hydronautics-team/DCDC_SAUVC26_PCB/Project Outputs for DCDC_SAUVC26_PCB/DCDC_SAUVC26_PCB.xlsx

Line # | Part Number | Description | Designator | Quantity
1 | Capacitor_0,01n_10_50V_X7R_0603C | Конденсатор | C1 | 1
2 | Capacitor_0,15n_10_50V_X7R_0603C | Конденсатор | C2 | 1
3 | Capacitor_0,75n_10_50V_X7R_0603C | Конденсатор | C3 | 1
4 | Capacitor_10n_10_50V_X7R_0603C | Конденсатор | C4, C26, C37 | 3
5 | Capacitor_0,1u_10_50V_X7R_0603C | Конденсатор | C5 | 1
6 | Capacitor_22u_10_25V_X7R_1210C | Конденсатор | C6, C7, C9, C11, C13, C15, C16, C18, C19, C21-23, C27, C28, C38, C39 | 16
7 | Capacitor_2,2u_10_50V_X7R_1206C | Конденсатор | C8, C10, C12, C14 | 4
8 | Capacitor_1u_10_50V_X7R_0603C | Конденсатор | C17, C20 | 2
9 | Capacitor_4,7u_10_50V_X7R_1206C | Конденсатор | C24, C25, C35, C36 | 4
10 | JCK1V101 | Конденсатор алюминиевый электролитический 100мкФ 35В 20% SMD 6,6x6,6 мм | C29, C34 | 2
11 | JCK1V331 | Конденсатор алюминиевый электролитический 1000мкФ 25В 20% Low ESR 1100мА SMD12.5x13.5мм | C30, C32, C33 | 3
12 | Capacitor_1n_10_50V_X7R_0603C | Конденсатор | C31 | 1
13 | LM5116MH | dc-dc понижающий adj 6-100v | DA1 | 1
14 | RT8279GSP | Преобразователь постоянного тока понижающий подстраиваемый выход 5А | DA2, DA4 | 2
16 | MC3306A | DC-DC понижающий/повышающий преобразователь, вход: 3 - 40 В, выход: 1,25 - 40 В 1,5 А | DD1 | 1
17 | LED | Светодиод | HL1-6 | 6
18 | CDSPRH127-150M | Индуктивность на 15 мкГн, номинальный ток 8,4 А | L1 | 1
19 | IHLP4040DZER330M11 | ЧИП-индуктивность экранированная 33мкГн ±20% 4,4A 94,5мОм 4040 | L2, L5 | 2
20 | CDSPRH127-331M | Индуктивность на 330 мкГн, номинальный ток 1,79 A | L3 | 1
21 | CDSP43-1R0M | Индуктивность на 1 мкГн, номинальный ток 4,3 A | L4 | 1
22 | res_0603_N/A | посадочное место 0603 под перемычку | R1 | 1
23 | Resistor_33k_1_0603 | Резистор номиналом 33 кОм и точностью 1% | R2, R17 | 2
 | Resistor_5.6k_1_0603 | Резистор номиналом 5,6 кОм 1% | R3 | 1
25 | Resistor_12.4k_1_0603 | Резистор номиналом 12,4 кОм и точностью 1% | R4 | 1
26 | Resistor_180k_1_0603 | Резистор номиналом 180 кОм и точностью 1% | R5 | 1
27 | Resistor_10k_1_0603 | Резистор номиналом 10 кОм и точностью 1% | R6, R14, R16 | 3
28 | Resistor_470k_1_0603 | Резистор номиналом 470 кОм и точностью 1% | R7 | 1
29 | RL1210FR-070R01L | Резистор номиналом 10 мОм, точностью 1%, 0.5Вт | R8 | 1
30 | Resistor_10.7k_1_0603 | Резистор номиналом 10,7 кОм и точностью 1% | R9 | 1
31 | Resistor_1.21k_1_0603 | Резистор номиналом 1,21 кОм и точностью 1% | R10 | 1
32 | Resistor_1.0k_1_0603 | Резистор номиналом 1,0 кОм и точностью 1% | R11, R28 | 2
33 | Resistor_31.6k_1_0603 | Резистор номиналом 31,6 кОм и точностью 1% | R12 | 1
34 | Resistor_100k_1_0603 | Резистор номиналом 100 кОм и точностью 1% | R13, R30 | 2
35 | Resistor_27k_1_0603 | Резистор номиналом 27 кОм и точностью 1% | R15 | 1
36 | Resistor_2.2k_1_0603 | Резистор номиналом 2,2 кОм и точностью 1% | R18, R19 | 2
37 | Resistor_0.22_1_2512 | Резистор номиналом 0,22 Ом и точностью 1% | R20 | 1
 | Resistor_390_1_0603 | Резистор номиналом 390 Ом 1% | R21 | 1
39 | Resistor_180_1_0603 | Резистор номиналом 180 Ом и точностью 1% | R23 | 1
 | Resistor_7.5k_1_0603 | Резистор номиналом 7,5 кОм 1% | R24 | 1
41 | Resistor_11k_1_0603 | Резистор номиналом 11 кОм и точностью 1% | R29 | 1
42 | ES1D-E3/61T | Диод 1A 200V | VD1 | 1
43 | BAT54WS | Диод шоттки на 30 В, ном. ток 0.2 А | VD2, VD5 | 2
 | 10S45SP | Диод шоттки на 45 В, ном. ток 10 А | VD3, VD6 | 2
45 | 20MQ100 | Диод шоттки на 100 В, ном. ток 2 А | VD4 | 1
46 | PDTC114ET | цифровой npn 50в 100мА | VT1, VT2 | 2
47 | SIR426DP-T1-GE3 | Транзистор полевой MOSFET N-канальный 40В 41.7Вт | VT3, VT4 | 2
48 | PLD-40 | Гребенка 40 пинов | XP1 | 1
