hydronautics-team/DCDC_SAUVC26_PCB/Project Outputs for DCDC_SAUVC26_PCB/ГИДР.123456.014-01.02/Документация/ГИДР.123456.014-01.02 ПЭ3.xlsx

Line # | Name | Description | Designator | Quantity | Manufacturer 1 | Manufacturer Part Number 1 | Manufacturer Lifecycle 1 | Supplier 1 | Supplier Part Number 1 | Supplier Unit Price 1 | Supplier Subtotal 1
13 | LM5116MH | dc-dc понижающий adj 6-100v | DA1 | 1
16 | MC3306A | DC-DC понижающий/повышающий преобразователь, вход: 3 - 40 В, выход: 1,25 - 40 В 1,5 А | DD1 | 1
48 | PLD-40 | Гребенка 40 пинов | XP1 | 1
42 | ES1D-E3/61T | Диод 1A 200V | VD1 | 1
43 | BAT54WS | Диод шоттки на 30 В, ном. ток 0.2 А | VD2, VD5 | 2
 | 10S45SP | Диод шоттки на 45 В, ном. ток 10 А | VD3, VD6 | 2
45 | 20MQ100 | Диод шоттки на 100 В, ном. ток 2 А | VD4 | 1
21 | CDSP43-1R0M | Индуктивность на 1 мкГн, номинальный ток 4,3 A | L4 | 1
18 | CDSPRH127-150M | Индуктивность на 15 мкГн, номинальный ток 8,4 А | L1 | 1
20 | CDSPRH127-331M | Индуктивность на 330 мкГн, номинальный ток 1,79 A | L3 | 1
1 | Capacitor | Конденсатор | C1 | 1
2 | Capacitor | Конденсатор | C2 | 1
3 | Capacitor | Конденсатор | C3 | 1
4 | Capacitor | Конденсатор | C4, C26, C37 | 3
5 | Capacitor | Конденсатор | C5 | 1
6 | Capacitor | Конденсатор | C6, C7, C9, C11, C13, C15, C16, C18, C19, C21-23, C27, C28, C38, C39 | 16
7 | Capacitor | Конденсатор | C8, C10, C12, C14 | 4
8 | Capacitor | Конденсатор | C17, C20 | 2
9 | Capacitor | Конденсатор | C24, C25, C35, C36 | 4
12 | Capacitor | Конденсатор | C31 | 1
10 | Capacitor | Конденсатор алюминиевый электролитический 100мкФ 35В 20% SMD 6,6x6,6 мм | C29, C34 | 2
11 | Capacitor | Конденсатор алюминиевый электролитический 1000мкФ 25В 20% Low ESR 1100мА SMD12.5x13.5мм | C30, C32, C33 | 3
15 | TS951ILT | Операционный усилитель Rail-to-Rail, 1-канальный | DA3 | 1
22 | Resistor | посадочное место 0603 под перемычку | R1 | 1
14 | RT8279GSP | Преобразователь постоянного тока понижающий подстраиваемый выход 5А | DA2, DA4 | 2
37 | Resistor | Резистор номиналом 0,22 Ом и точностью 1% | R20 | 1
32 | Resistor | Резистор номиналом 1,0 кОм и точностью 1% | R11, R28 | 2
31 | Resistor | Резистор номиналом 1,21 кОм и точностью 1% | R10 | 1
36 | Resistor | Резистор номиналом 2,2 кОм и точностью 1% | R18, R19 | 2
38 | Resistor | Резистор номиналом 3,0 кОм и точностью 1% | R22, R25 | 2
 | Resistor | Резистор номиналом 5,6 кОм 1% | R3 | 1
 | Resistor | Резистор номиналом 7,5 кОм 1% | R24 | 1
27 | Resistor | Резистор номиналом 10 кОм и точностью 1% | R6, R14, R16 | 3
29 | Resistor | Резистор номиналом 10 мОм, точностью 1%, 0.5Вт | R8 | 1
30 | Resistor | Резистор номиналом 10,7 кОм и точностью 1% | R9 | 1
41 | Resistor | Резистор номиналом 11 кОм и точностью 1% | R29 | 1
25 | Resistor | Резистор номиналом 12,4 кОм и точностью 1% | R4 | 1
40 | Resistor | Резистор номиналом 24 кОм и точностью 1% | R26, R27 | 2
35 | Resistor | Резистор номиналом 27 кОм и точностью 1% | R15 | 1
33 | Resistor | Резистор номиналом 31,6 кОм и точностью 1% | R12 | 1
23 | Resistor | Резистор номиналом 33 кОм и точностью 1% | R2, R17 | 2
34 | Resistor | Резистор номиналом 100 кОм и точностью 1% | R13, R30 | 2
26 | Resistor | Резистор номиналом 180 кОм и точностью 1% | R5 | 1
39 | Resistor | Резистор номиналом 180 Ом и точностью 1% | R23 | 1
 | Resistor | Резистор номиналом 390 Ом 1% | R21 | 1
28 | Resistor | Резистор номиналом 470 кОм и точностью 1% | R7 | 1
17 | LED | Светодиод | HL1-6 | 6
47 | SIR426DP-T1-GE3 | Транзистор полевой MOSFET N-канальный 40В 41.7Вт | VT3, VT4 | 2
46 | PDTC114ET | цифровой npn 50в 100мА | VT1, VT2 | 2
19 | IHLP4040DZER330M11 | ЧИП-индуктивность экранированная 33мкГн ±20% 4,4A 94,5мОм 4040 | L2, L5 | 2
