hydronautics-team/DCDC_SAUVC26_PCB/(list of files, cad)

Other CAD files:
Project Outputs for DCDC_SAUVC26_PCB/ГИДР.123456.014-01.02/Mechanical models/DCDC_SAUVC26.DWG
