hydronautics-team/DCDC_SAUVC26_PCB/Project Outputs for DCDC_SAUVC26_PCB/ГИДР.123456.014-01.02/Документация/ГИДР.123456.014-01.02 Э3.PDF

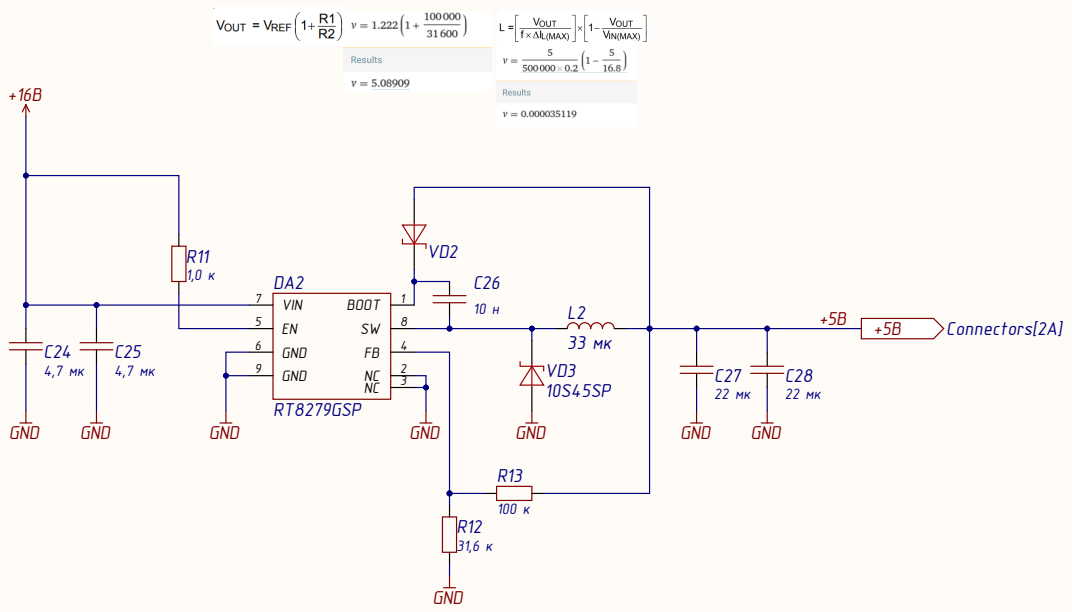
[picture p1: page 1]

Инв. № подл. Инв. № дубл. Подп. и дата Взам. инв. № Подп. и дата Перв. примен. Справ. №

ГИДР.123456.014-01.02 Э 3

Плат а преобразоват е л е й 5 С х ема э л е ктр и ч еск а я п р и нци и л ь н я | Лит . | Мас с а | Масш таб

Из м . | Ли с т | № д о к у м . | Подп . | Дат а
Разраб . | | Ми х а й л о вск и й | Г . | 14.09.20 2
Пров . | | Карман о в С .
Т .конт р . | | | | | Ли с т | Ли тов

Н .конт р .
Ут в . | *

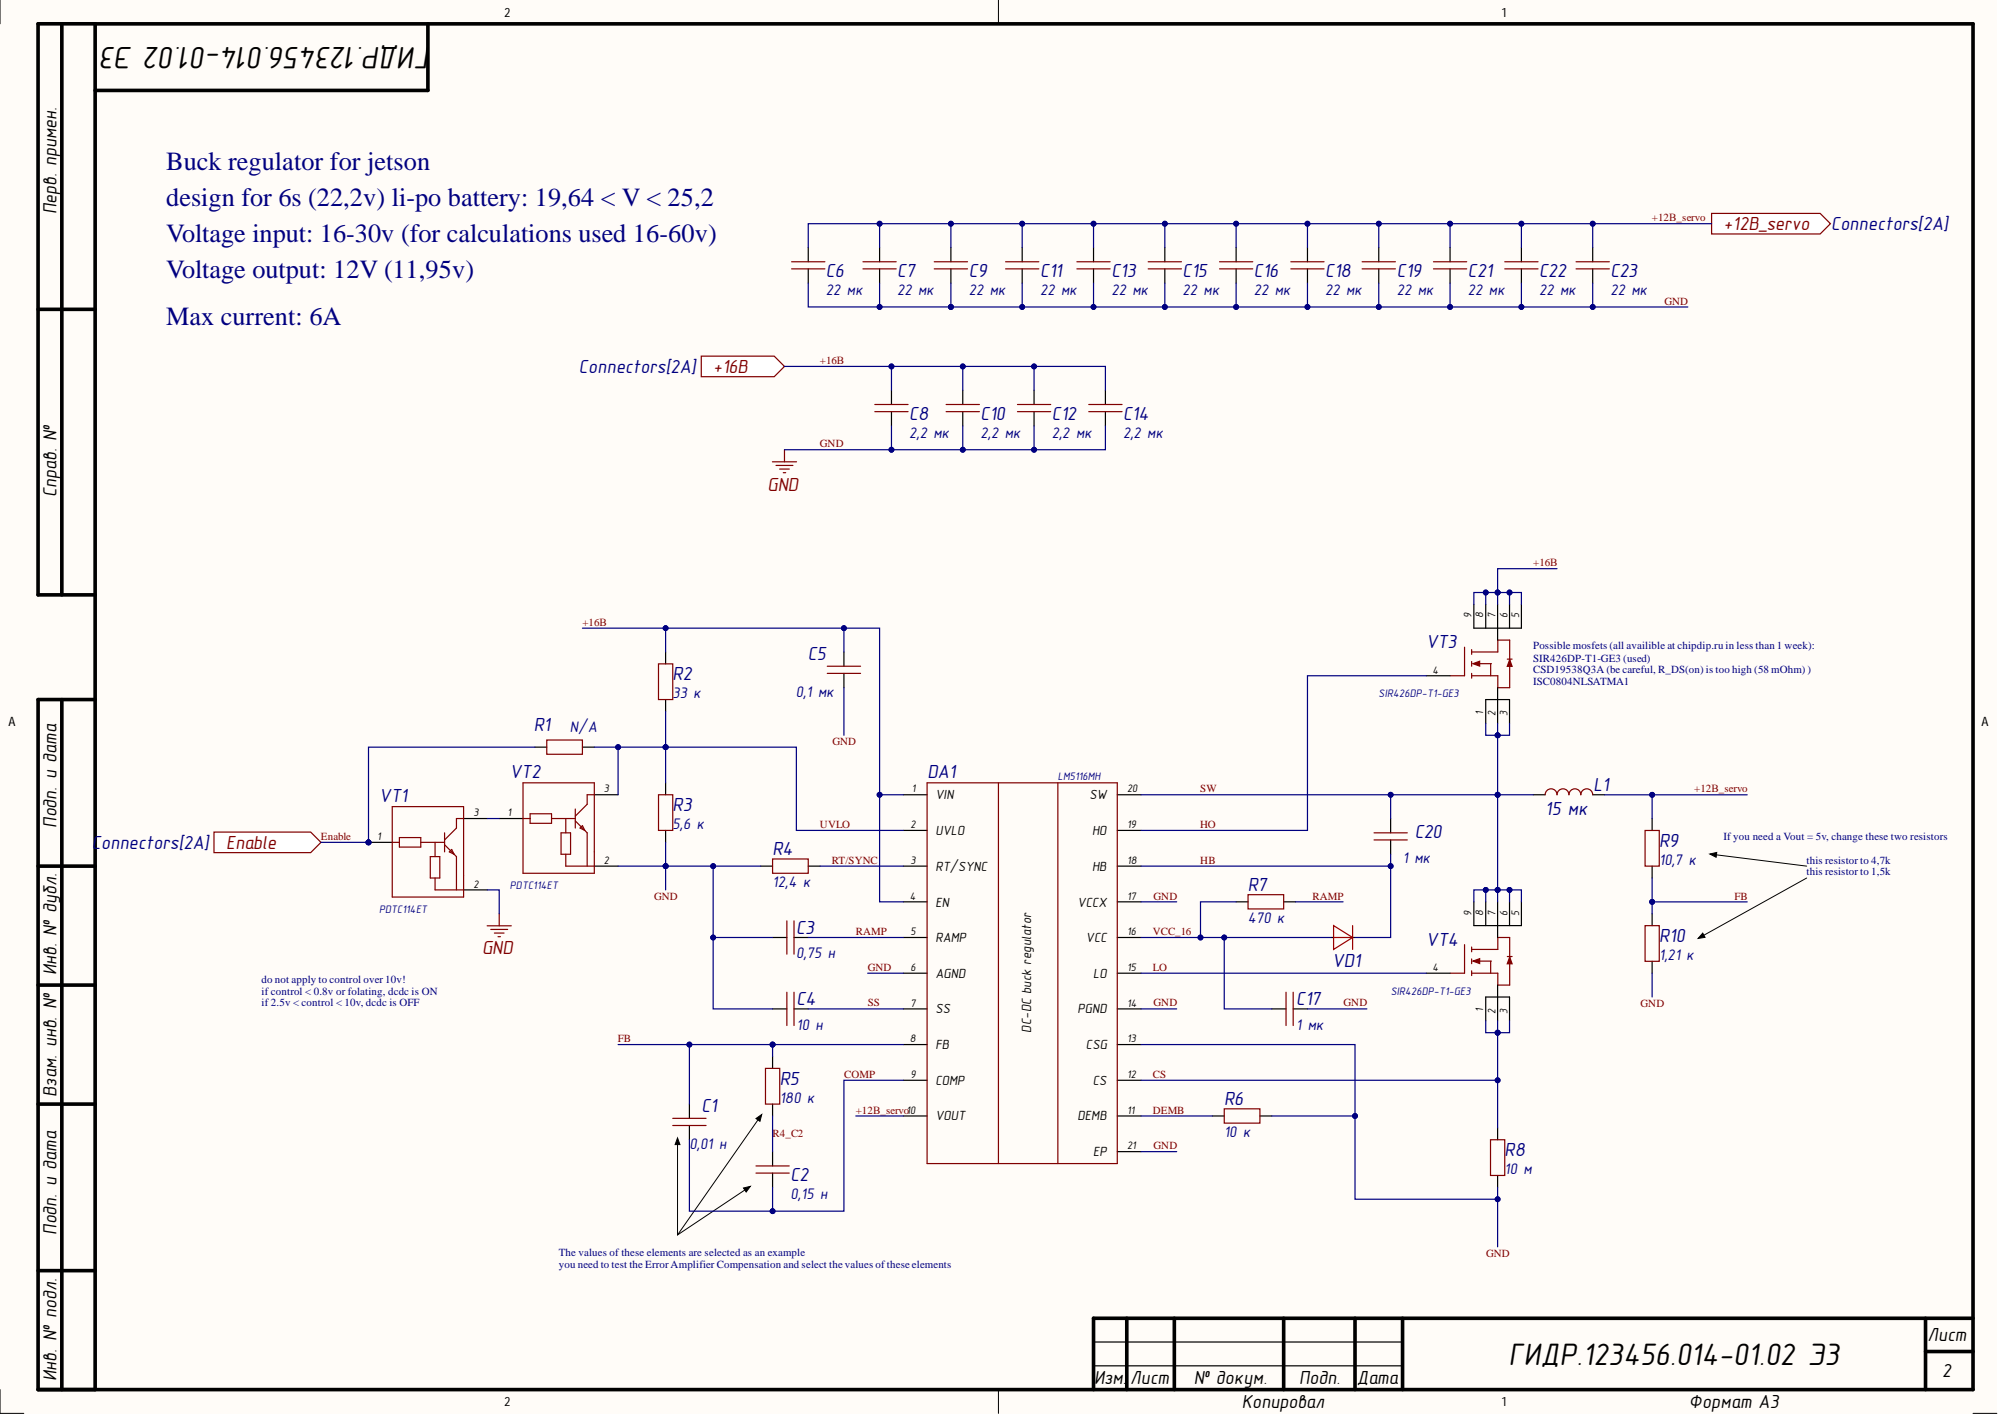
[picture p2: page 2]

Buck regulator for jetson
design for 6s (22,2v) li-po battery: 19,64 < V < 25,2
Voltage input: 16-30v (for calculations used 16-60v)
Voltage output: 12V (11,95v)

Possible mosfets (all availible at chipdip.ru in less than 1 week):
SIR426DP-T1-GE3 (used)
CSD19538Q3A (be careful, R_DS(on) is too high (58 mOhm) )
ISC0804NLSATMA1

If you need a Vout = 5v, change these two resistors

DC-DC buck regulator

do not apply to control over 10v!
if control < 0.8v or folating, dcdc is ON
if 2.5v < control < 10v, dcdc is OFF

The values of these elements are selected as an example
you need to test the Error Amplifier Compensation and select the values of these elements

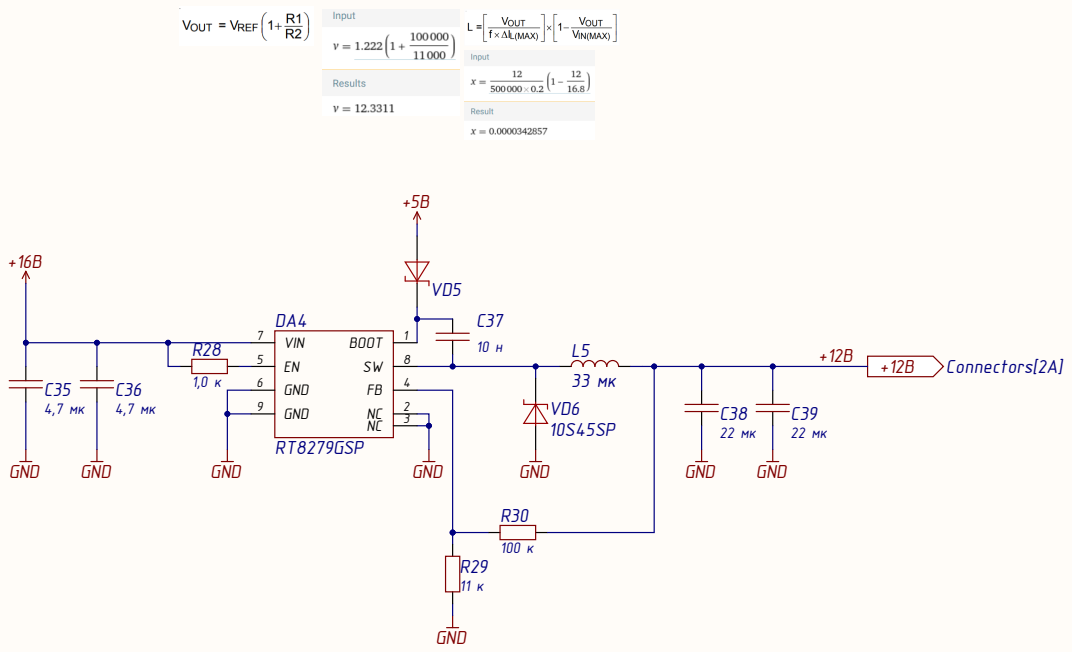
[picture p3: page 3]

Инв. № подл. Инв. № дубл. Подп. и дата Взам. инв. № Подп. и дата Перв. примен. Справ. №

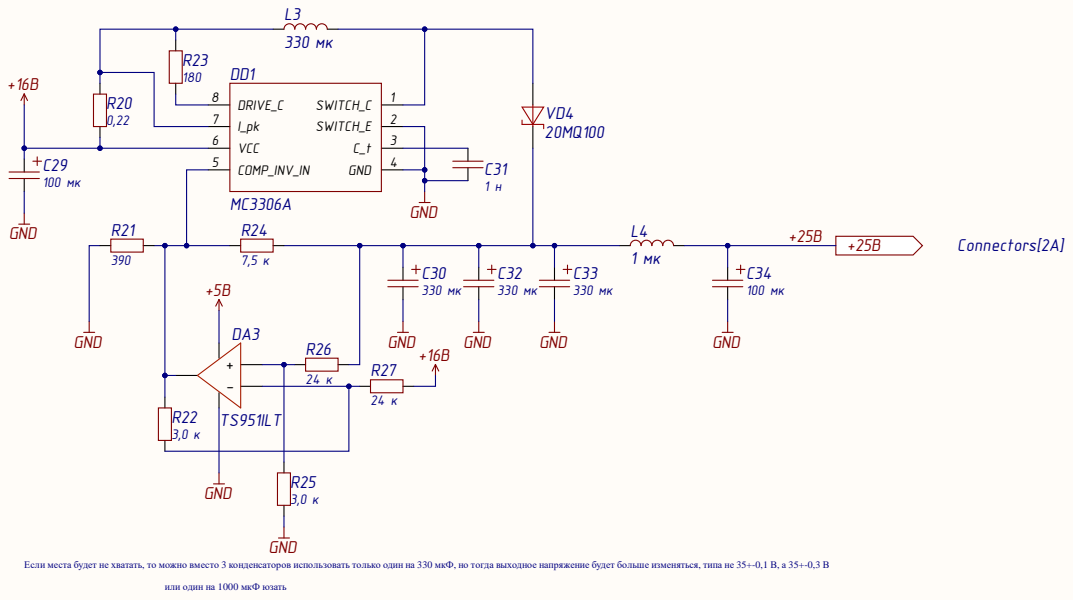
[picture p4: page 4]

Если места будет не хватать, то можно вместо 3 конденсаторов использовать только один на 330 мкФ, но тогда выходное напряжение будет больше изменяться, типа не 35+-0,1 В, а 35+-0,3 В

или один на 1000 мкФ юзать

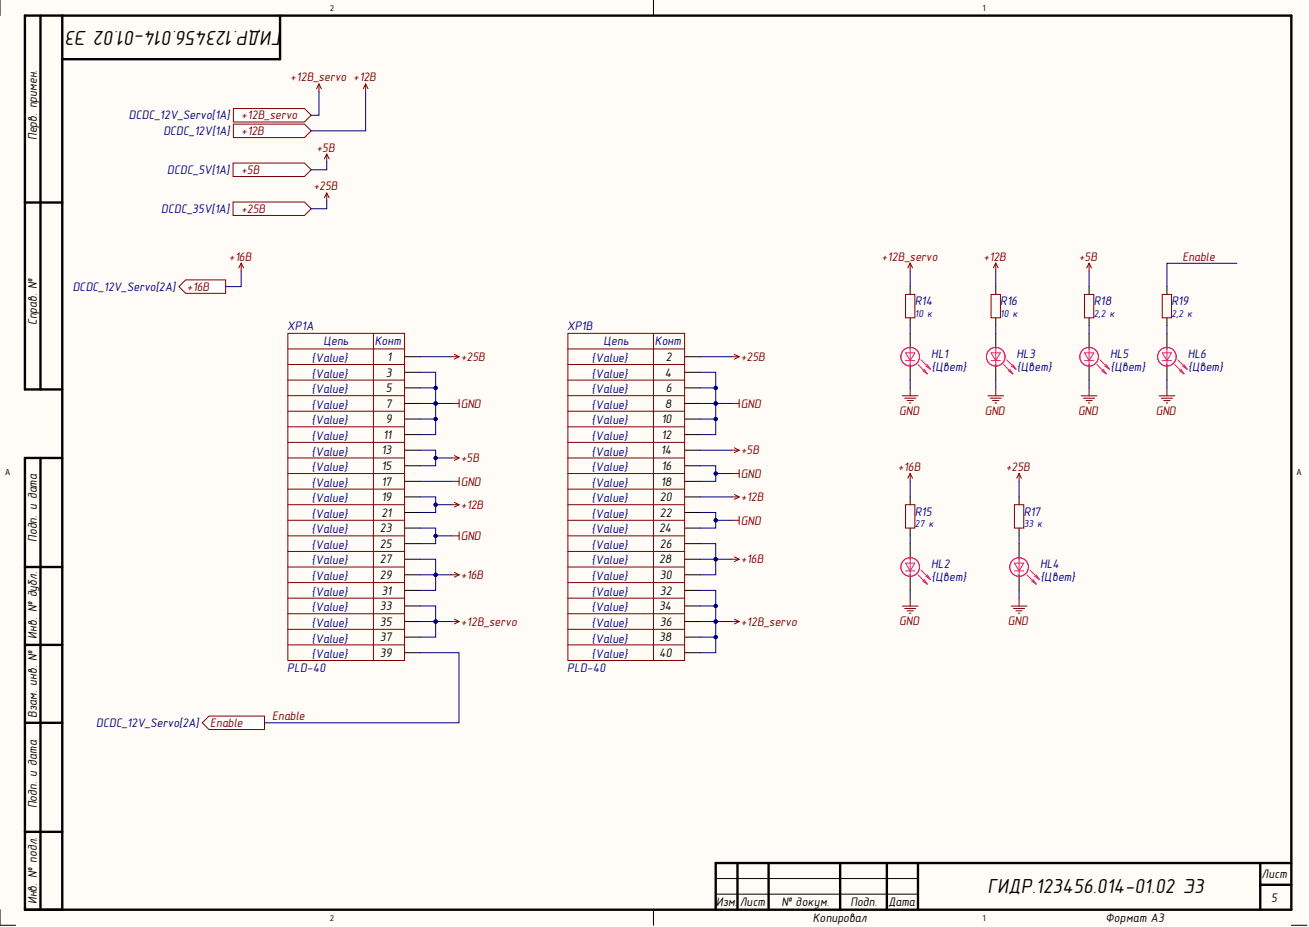
[picture p5: page 5]

Инв. № подл. Инв. № дубл. Подп. и дата Взам. инв. № Подп. и дата Перв. примен. Справ. №
