hydronautics-team/DCDC_SAUVC26_PCB/Project Outputs for DCDC_SAUVC26_PCB/ГИДР.123456.014-01.02/Документация/ГИДР.123456.014-01.02 СБ.PDF

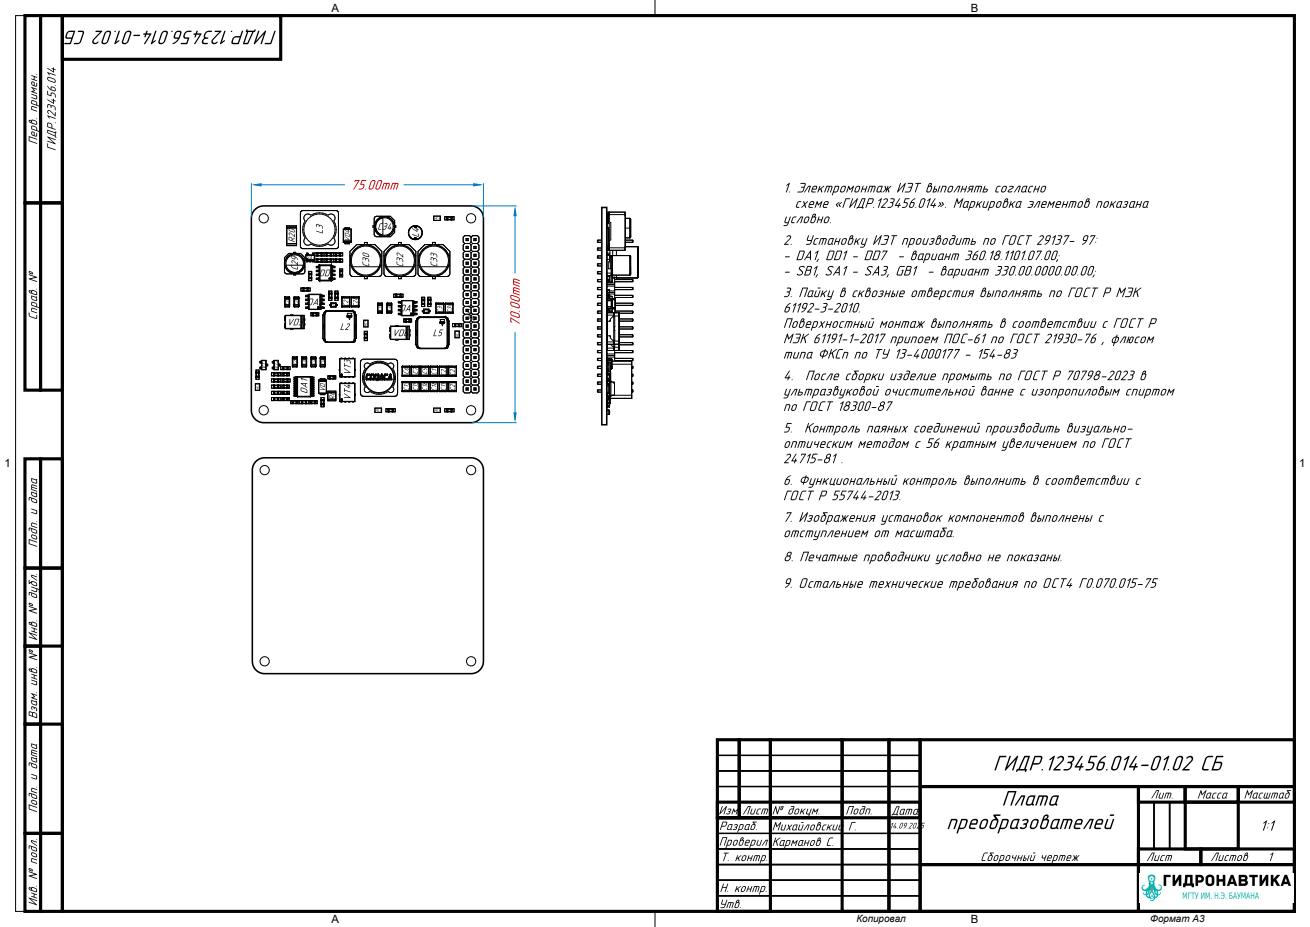
[picture p6: page 1]
