hydronautics-team/DCDC_SAUVC26_PCB/Project Outputs for DCDC_SAUVC26_PCB/ГИДР.123456.014-01.02/Документация/ГИДР.123456.014-01.02.PDF

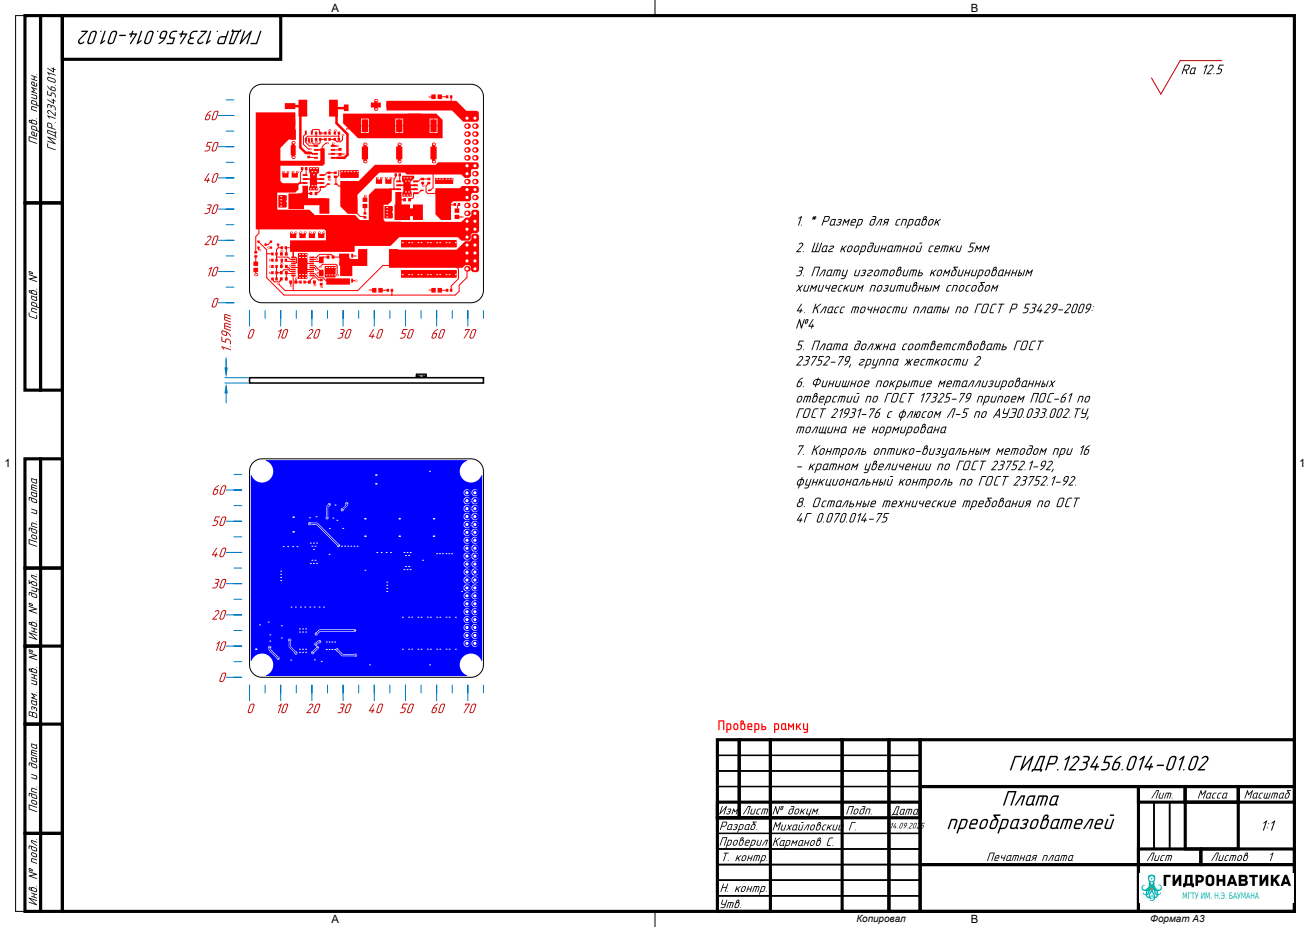
[picture p7: page 1]
