hydronautics-team/DCDC_SAUVC26_PCB/(list of files, drawings)

Other design files:
Connectors.SchDoc
DCDC_5V.SchDoc
DCDC_12V.SchDoc
DCDC_12V_Servo.SchDoc
DCDC_35V.SchDoc
DCDC_SAUVC26.PcbDoc
DCDC_SAUVC26_PCB.PrjPcb
Project Outputs for DCDC_SAUVC26_PCB/Sources/Connectors.SchDoc
Project Outputs for DCDC_SAUVC26_PCB/Sources/DCDC_5V.SchDoc
Project Outputs for DCDC_SAUVC26_PCB/Sources/DCDC_12V.SchDoc
Project Outputs for DCDC_SAUVC26_PCB/Sources/DCDC_12V_Servo.SchDoc
Project Outputs for DCDC_SAUVC26_PCB/Sources/DCDC_35V.SchDoc
Project Outputs for DCDC_SAUVC26_PCB/Sources/DCDC_SAUVC26.PcbDoc
Project Outputs for DCDC_SAUVC26_PCB/Sources/DCDC_SAUVC26_PCB.PrjPcb
