hydronautics-team/DCDC_SAUVC26_PCB/(commit log)

2025-08-20 Schematic edited
    [Connectors.SchDoc, DCDC_12V.SchDoc, DCDC_35V.SchDoc, DCDC_5V.SchDoc, DCDC_SAUVC26.PcbDoc, DCDC_SAUVC26_PCB.PrjPcb, LEDs_indication.SchDoc, Main.SchDoc]
2025-08-20 Schematic done
    [Connectors.SchDoc, DCDC_12V.SchDoc, DCDC_12V_Servo.SchDoc, DCDC_35V.SchDoc, DCDC_5V.SchDoc, DCDC_SAUVC26.PcbDoc, DCDC_SAUVC26_PCB.PrjPcb]
2025-08-27 Placement done
    [Connectors.SchDoc, DCDC_12V.SchDoc, DCDC_12V_Servo.SchDoc, DCDC_35V.SchDoc, DCDC_5V.SchDoc, DCDC_SAUVC26.PcbDoc, DCDC_SAUVC26_PCB.PrjPcb]
2025-08-27 Layout done
    [Connectors.SchDoc, DCDC_SAUVC26.PcbDoc, DCDC_SAUVC26_PCB.PrjPcb]
2025-08-27 Silkscreen done
    [DCDC_SAUVC26.PcbDoc]
2025-09-01 Silk fixed
    [DCDC_SAUVC26.PcbDoc]
2025-09-03 Fix connector placement
    [DCDC_SAUVC26.PcbDoc]
2025-09-13 Fixed output
    [DCDC_SAUVC26_PCB.PrjPcb]
2025-09-13 Fixed name of assembly
    [DCDC_SAUVC26_PCB.PrjPcb]
2025-09-13 Finish release
    [Connectors.SchDoc, DCDC_12V.SchDoc, DCDC_12V_Servo.SchDoc, DCDC_35V.SchDoc, DCDC_5V.SchDoc, DCDC_SAUVC26.DWG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]
2025-09-14 Board outline fixed
    [DCDC_SAUVC26.PcbDoc]
2025-09-14 BOM fixed
    [DCDC_SAUVC26_PCB.PrjPcb]
2025-10-03 changed resistors for 16V
    [DCDC_12V_Servo.SchDoc, DCDC_35V.SchDoc, DCDC_SAUVC26.PcbDoc, DCDC_SAUVC26_PCB.PrjPcb]
2025-10-03 Changed vbat 24v to 16v
    [Connectors.SchDoc, DCDC_12V.SchDoc, DCDC_12V_Servo.SchDoc, DCDC_35V.SchDoc, DCDC_5V.SchDoc, DCDC_SAUVC26.PcbDoc]
2025-10-04 fixed BOM
    [DCDC_SAUVC26_PCB.xlsx]
2025-10-05 fixed silk and mask
    [DCDC_SAUVC26.PcbDoc]
2025-10-05 Release, Rezonit DRC done
    [DCDC_SAUVC26.DWG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]
